PHANzgz/PHANAND_ONE/Demo/IMG-20191007-WA0003.jpeg

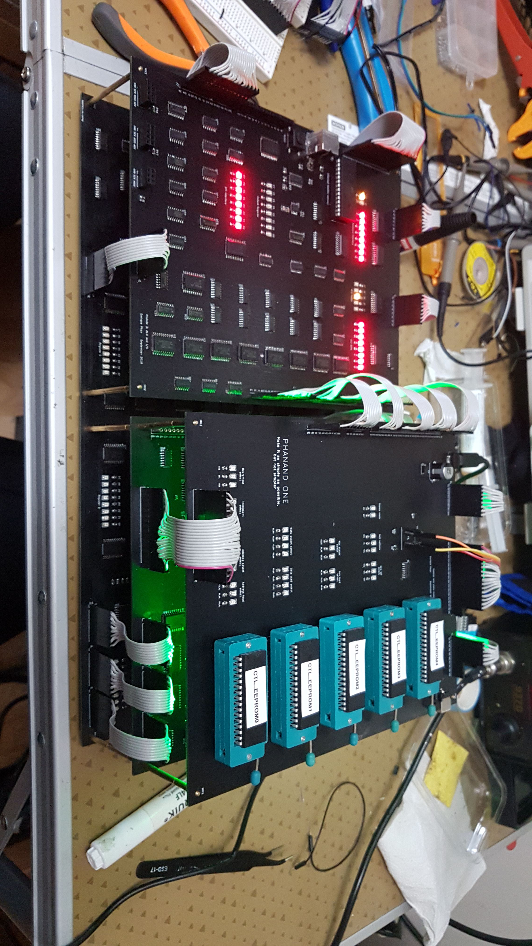
Demo/IMG-20191007-WA0003.jpeg
