PHANzgz/PHANAND_ONE/Demo/IMG-20190930-WA0027.jpeg

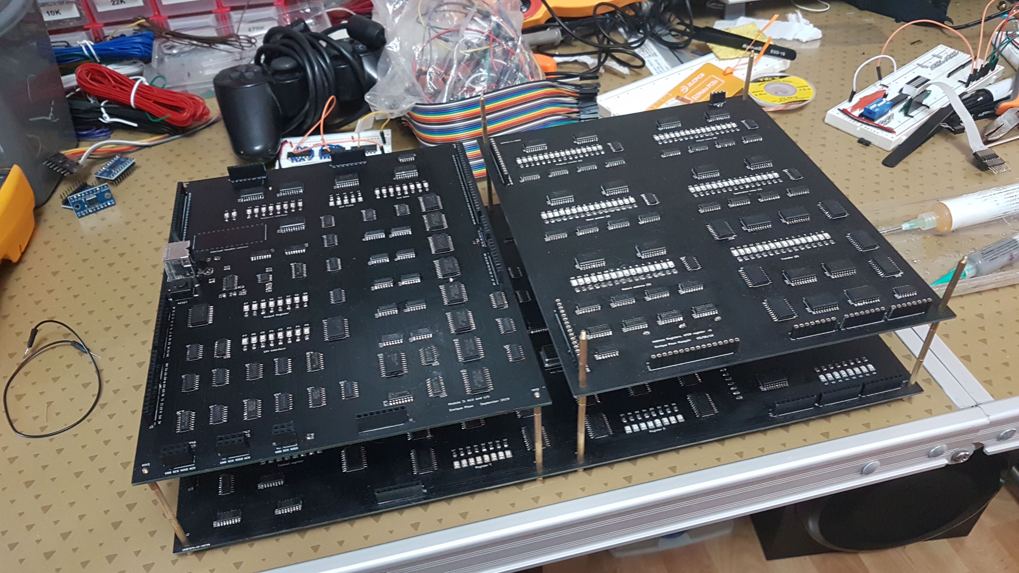
Demo/IMG-20190930-WA0027.jpeg
