PHANzgz/PHANAND_ONE/Documentation/Standalone_VGAcontroller.pdf

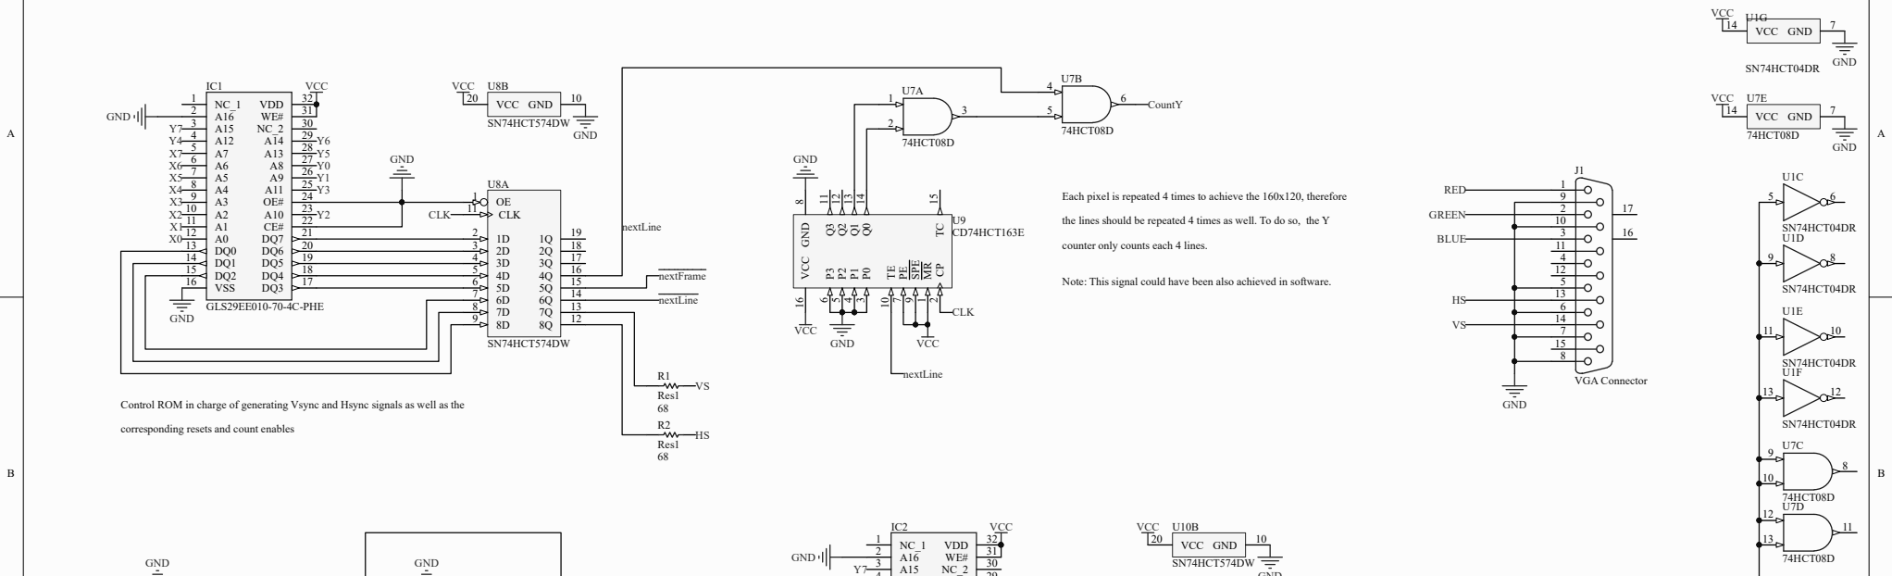
[picture p5: figure]
VCC 14; GND; SN74HCT04DR GND; VCC; NC_1 1 A16 2 A15 3 A12 4 A7 5 A6 6 A5 7 A4 8 A3 9 A2 10 A1 11 A0 12 DQ0 13 DQ1 14 DQ2 15 VSS 16; VDD; GLS29EE010-70-4C-PHE; OE 1 CLK 11; SN74HCT574DW; 10 VCC 20; CLK MR 1 CP 2 P0; 7 GND; 8 SPE; U9 CD74HCT163E; 74HCT08D; Res1; VGA Connector; nextLine; nextFrame; CountY; RED; BLUE; GREEN; corresponding resets and count enables; counter only counts each 4 lines.; SN74HCT04DR; CLK
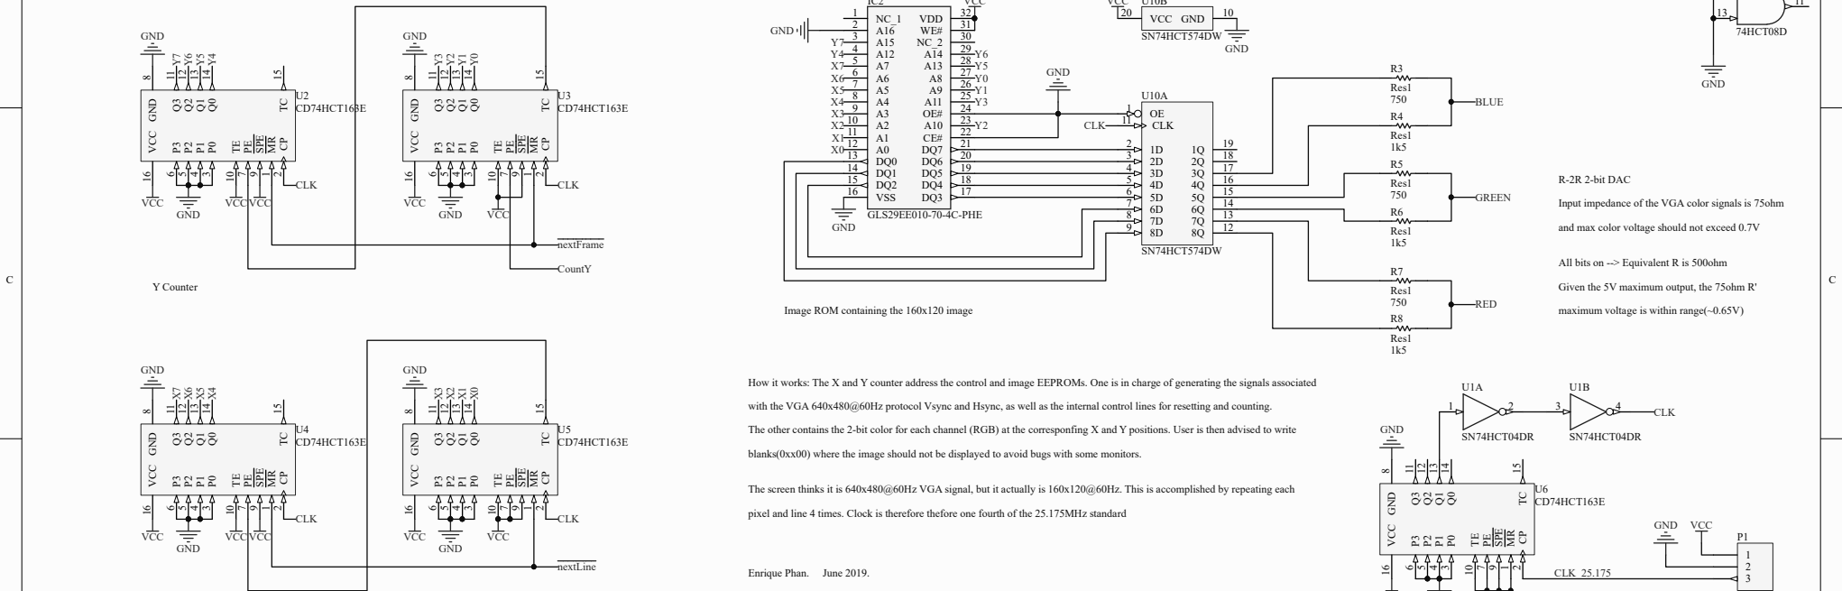
[picture p6: figure]
7 GND; 8 SPE; CD74HCT163E; CD74HCT163E MR 1 CP 2 P0; U3 CD74HCT163E; GND; VCC; CLK_25.175; GND VCC MR; U6 CD74HCT163E; SN74HCT04DR; CLK; VCCVCC; nextLine; CountY; nextFrame; A15 3 A12 4 A7 5 A6 6 A5 7 A4 8 A3 9 A2 10 A1 11 A0 12 DQ0 13 DQ1 14 DQ2 15 VSS 16; GLS29EE010-70-4C-PHE; OE 1 CLK 11; SN74HCT574DW; Res1; RED; GREEN; BLUE; Y Counter; Image ROM containing the 160x120 image; R-2R 2-bit DAC; All bits on --> Equivalent R is 500ohm; maximum voltage is within range(~0.65V); Enrique Phan. June 2019.
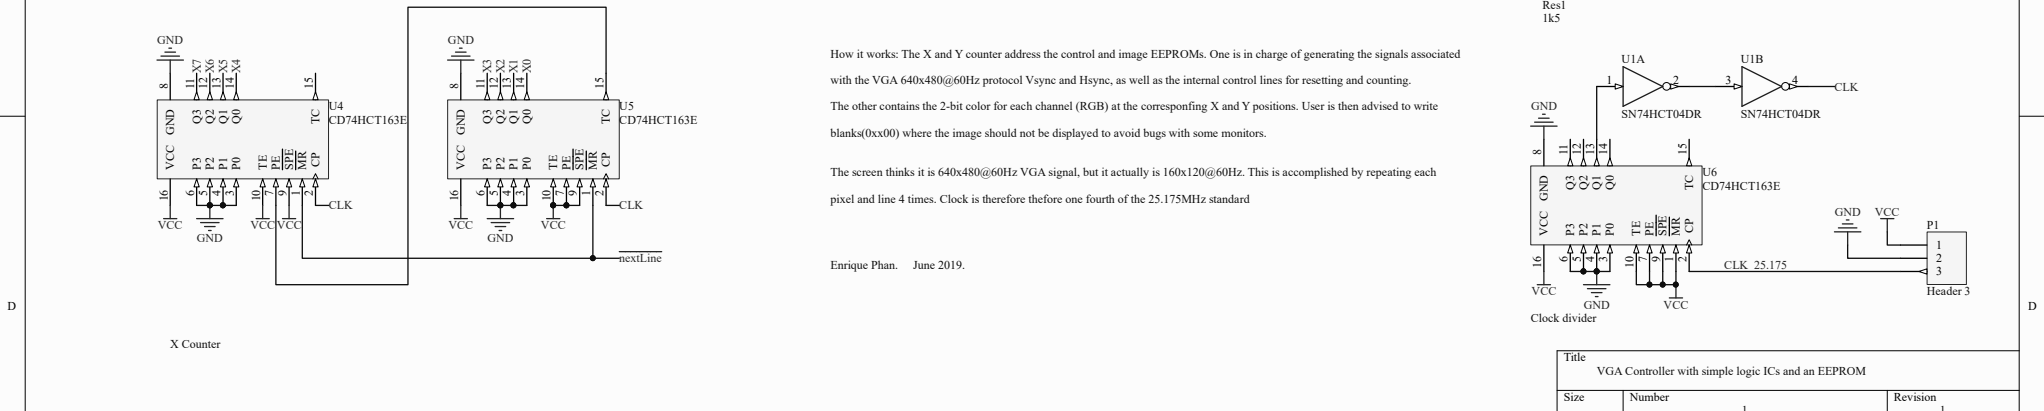
[picture p7: figure]
Title; Size; Number; Revision; Header 3; VCC; X Counter; Clock divider; GND

1

1

2

2

3

3

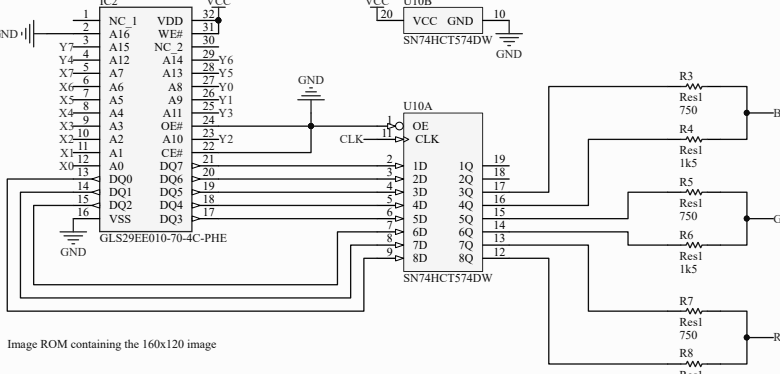
[picture p8: figure]

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
Date: | 07/07/2019 | Sheet | of
File: | C:\Users\..\VGAcrt.SchDoc | Drawn By:

VGA Controller with simple logic ICs and an EEPROM MR

### 9 TE 10 Q3 11 Q2 12 Q1 13 Q0 14 TC 15 VCC 16

### 9 TE 10 Q3 11 Q2 12 Q1 13 Q0 14 TC 15 VCC 16

### 9 TE 10 Q3 11 Q2 12 Q1 13 Q0 14 TC 15 VCC 16

### 9 TE 10 Q3 11 Q2 12 Q1 13 Q0 14 TC 15 VCC 16

### 9 TE 10 Q3 11 Q2 12 Q1 13 Q0 14 TC 15 VCC 16

CLK | CLK X⁷ X⁶ X⁵ X⁴ | X³ X² X¹ X⁰ Y⁷ Y⁶ Y⁵ Y⁴ | Y³ Y² Y¹ Y⁰

### 9 TE 10 Q3 11 Q2 12 Q1 13 Q0 14 TC 15 VCC 16

Enrique Phan

1 1

1 1

Control ROM in charge of generating Vsync and Hsync signals as well as the

Each pixel is repeated 4 times to achieve the 160x120, therefore

the lines should be repeated 4 times as well. To do so, the Y

Note: This signal could have been also achieved in software.

Input impedance of the VGA color signals is 75ohm

and max color voltage should not exceed 0.7V

Given the 5V maximum output, the 75ohm R'

How it works: The X and Y counter address the control and image EEPROMs. One is in charge of generating the signals associated

with the VGA 640x480@60Hz protocol Vsync and Hsync, as well as the internal control lines for resetting and counting.

The other contains the 2-bit color for each channel (RGB) at the corresponfing X and Y positions. User is then advised to write

blanks(0xx00) where the image should not be displayed to avoid bugs with some monitors.

The screen thinks it is 640x480@60Hz VGA signal, but it actually is 160x120@60Hz. This is accomplished by repeating each

pixel and line 4 times. Clock is therefore thefore one fourth of the 25.175MHz standard
