PHANzgz/PHANAND_ONE/Demo/20190929_234833.jpg

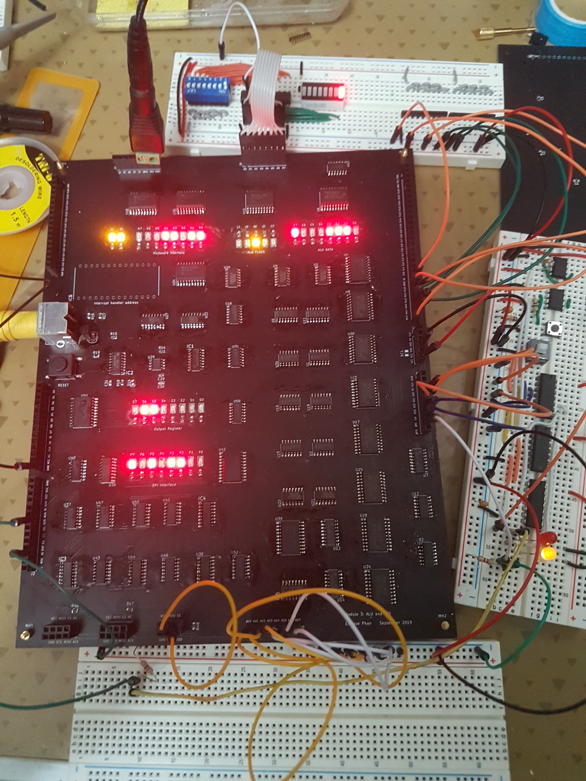
Demo/20190929_234833.jpg
