PHANzgz/PHANAND_ONE/Demo/AddressRegisters.jpeg

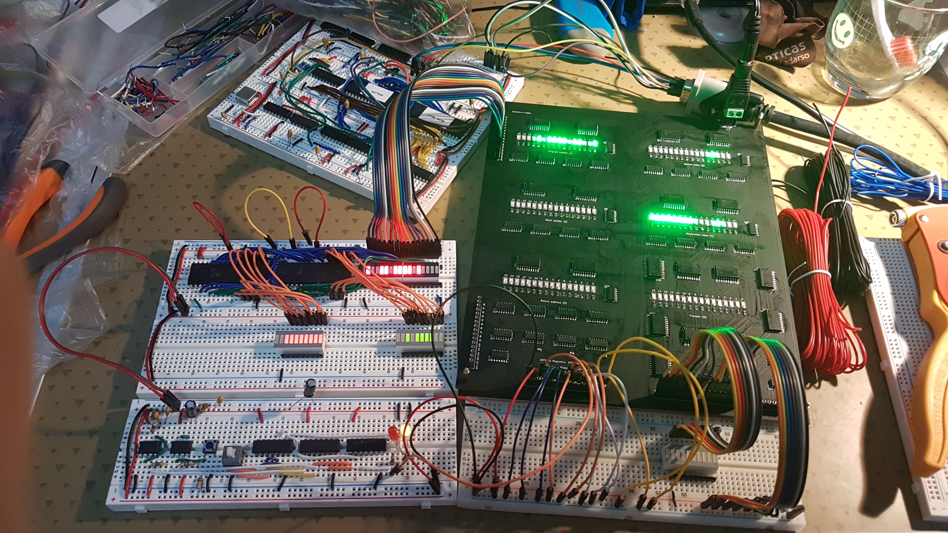
Demo/AddressRegisters.jpeg
