PHANzgz/PHANAND_ONE/Demo/DataModule.jpg

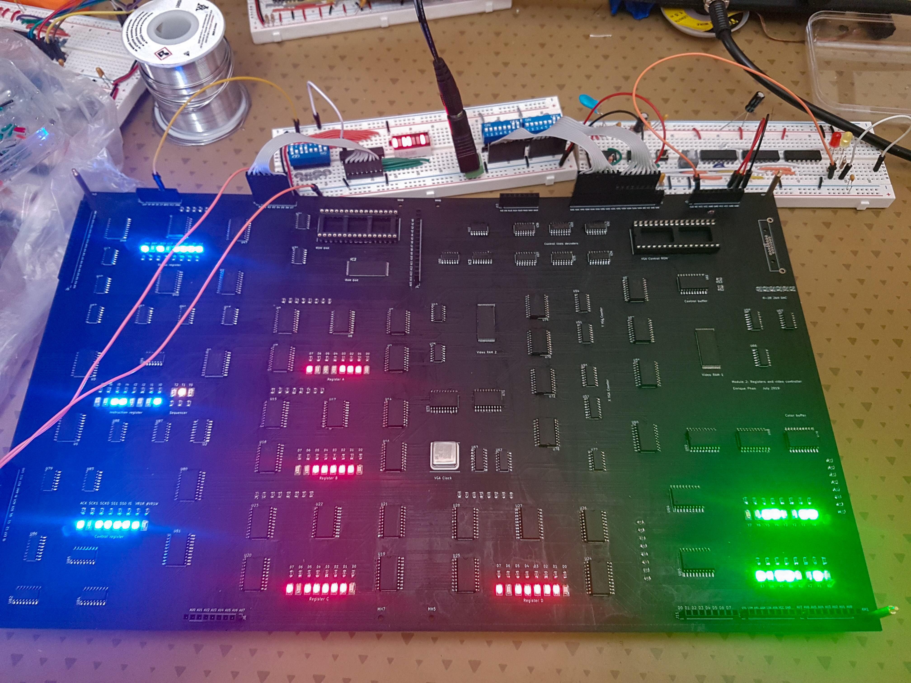
Demo/DataModule.jpg
