PHANzgz/PHANAND_ONE/Demo/VGA_Controller.jpg

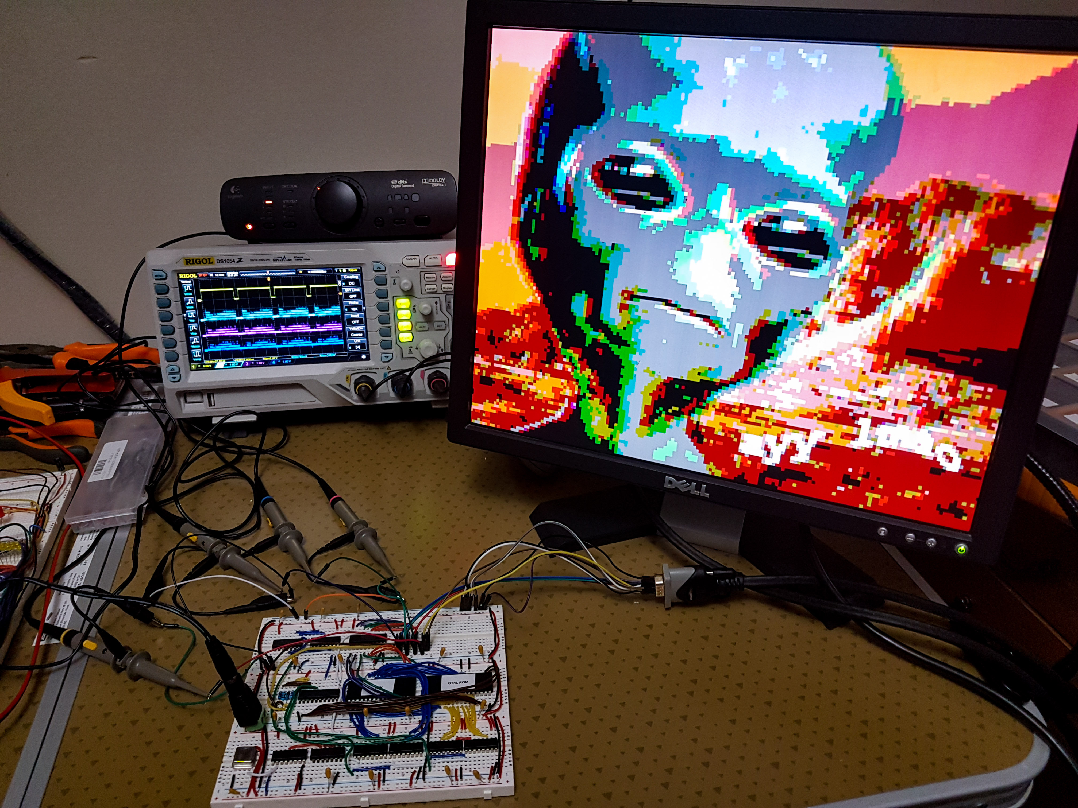
Demo/VGA_Controller.jpg
