PHANzgz/PHANAND_ONE/Schematics/addressRegisters.pdf

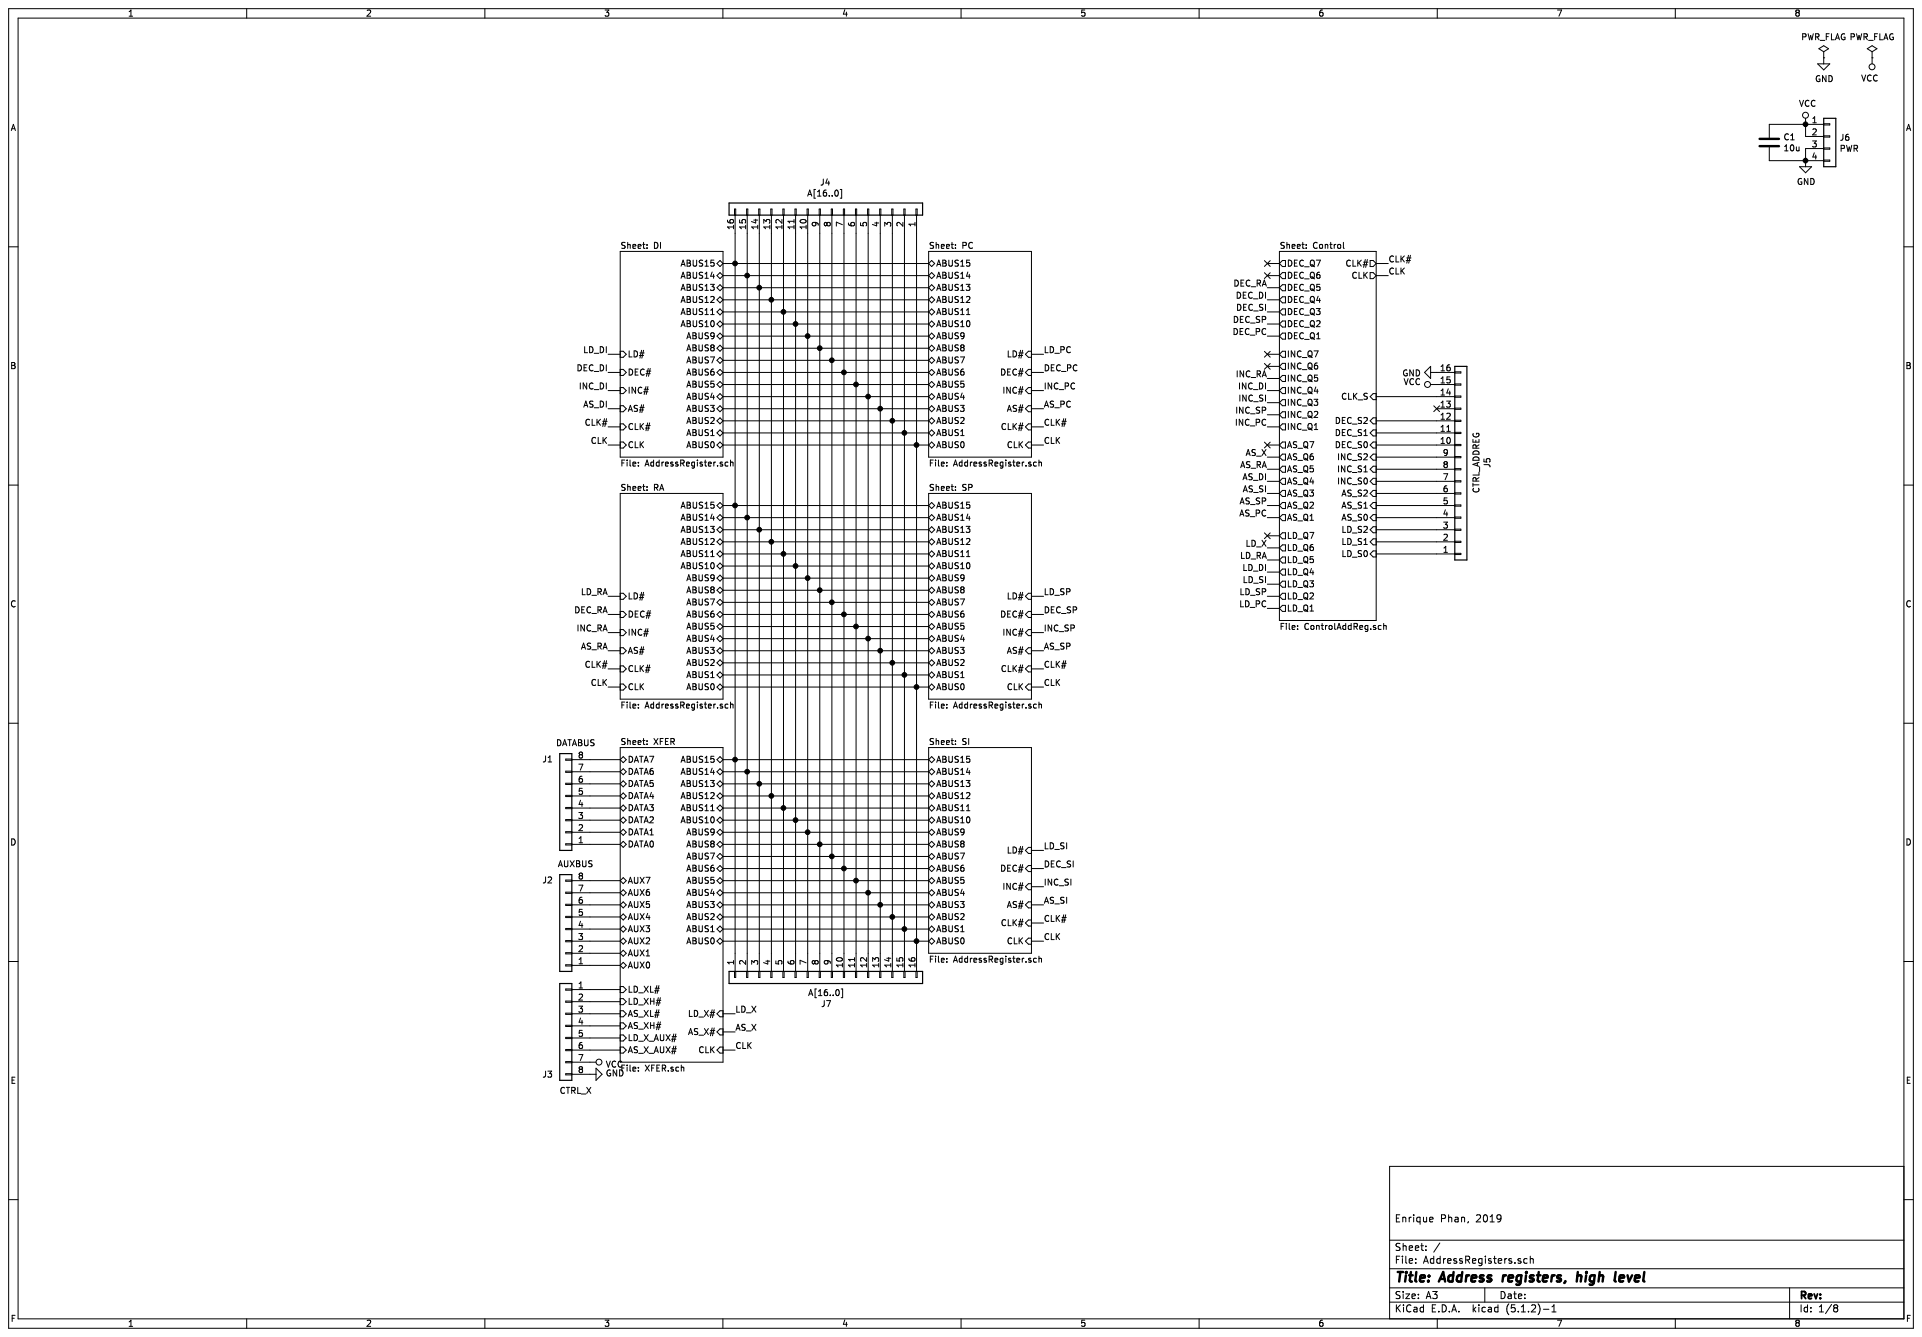
[picture p14: page 1]

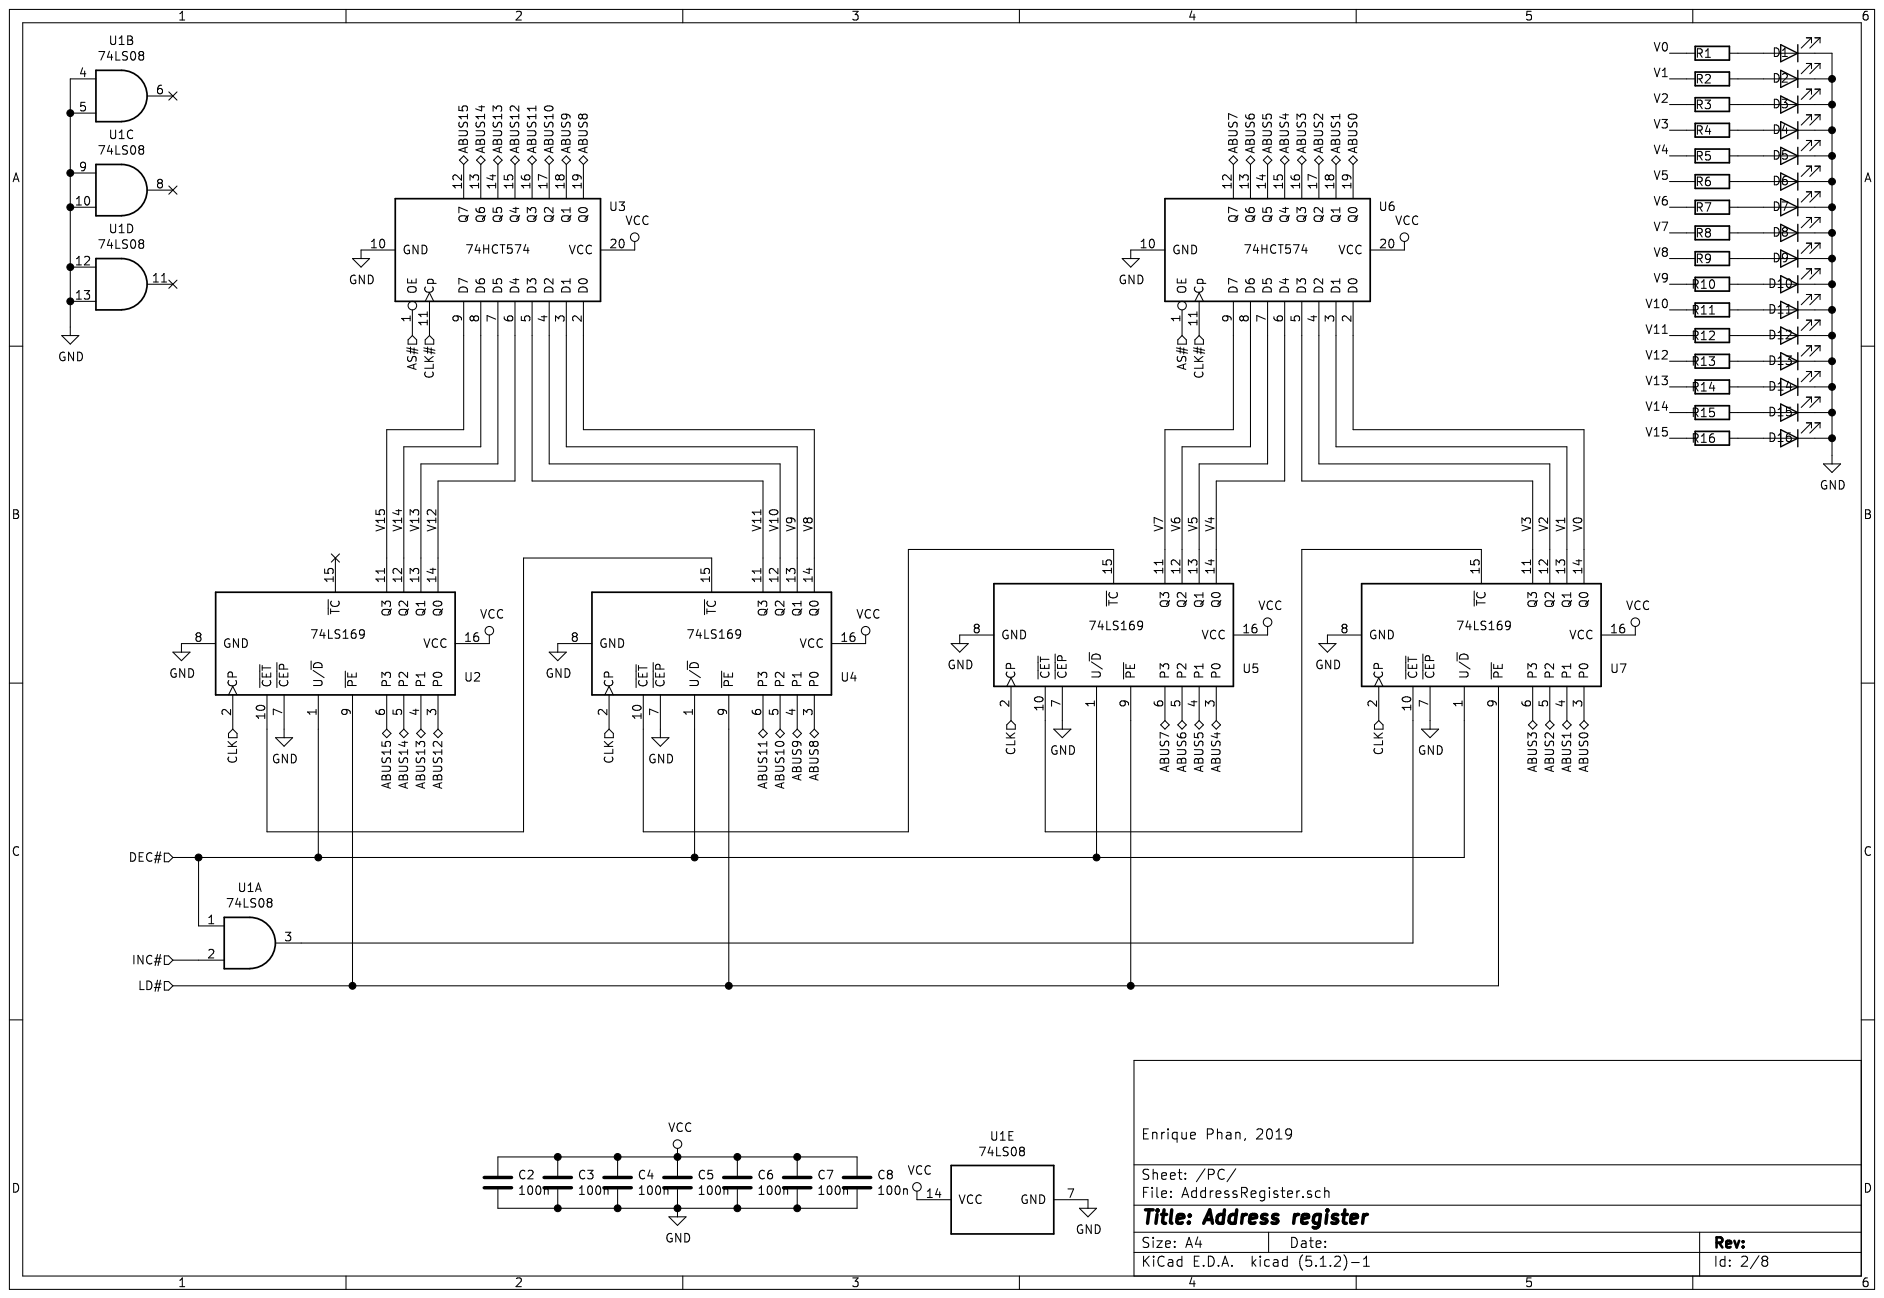
[picture p15: page 2]

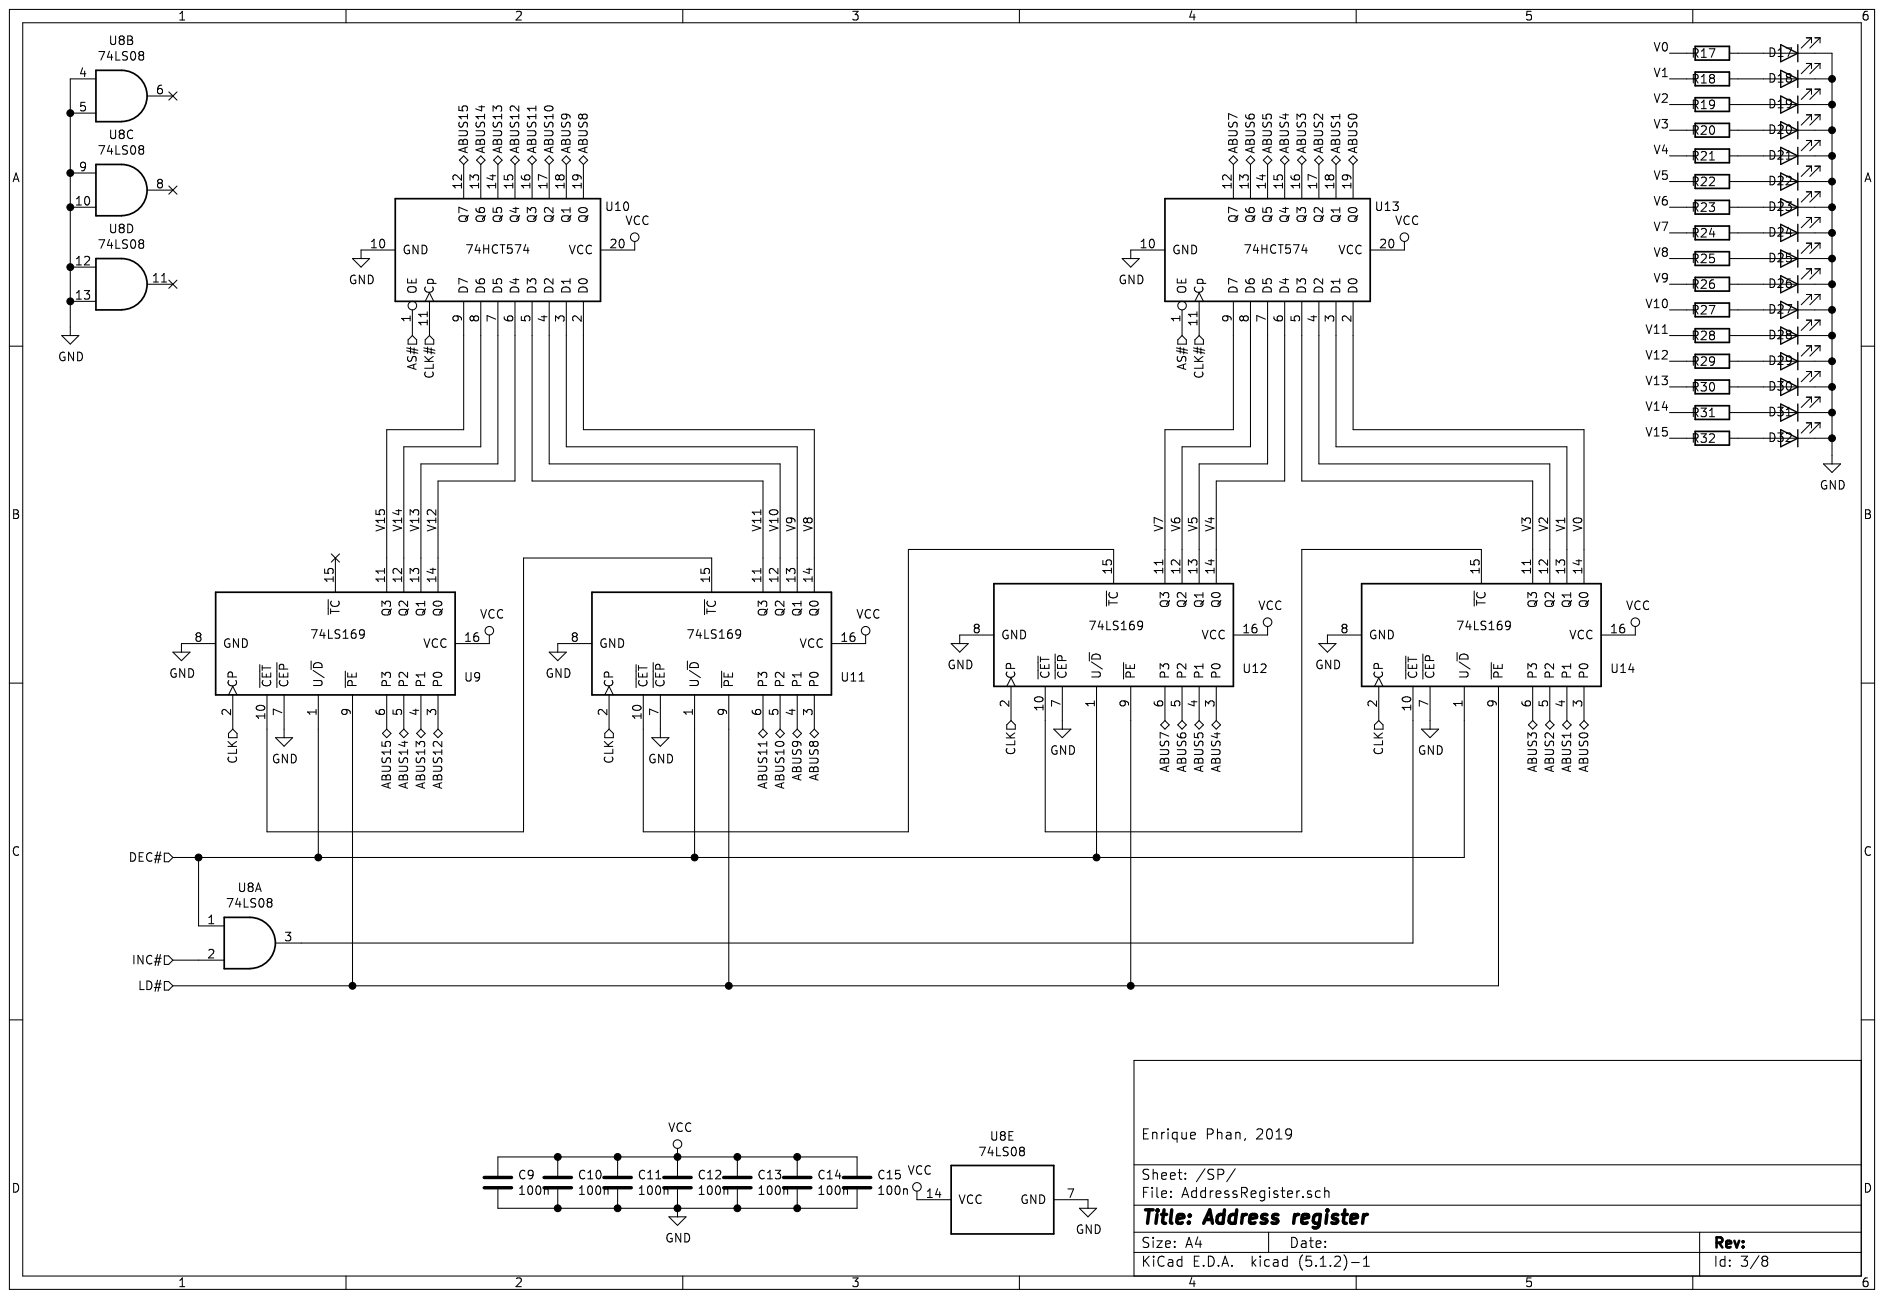
[picture p16: page 3]

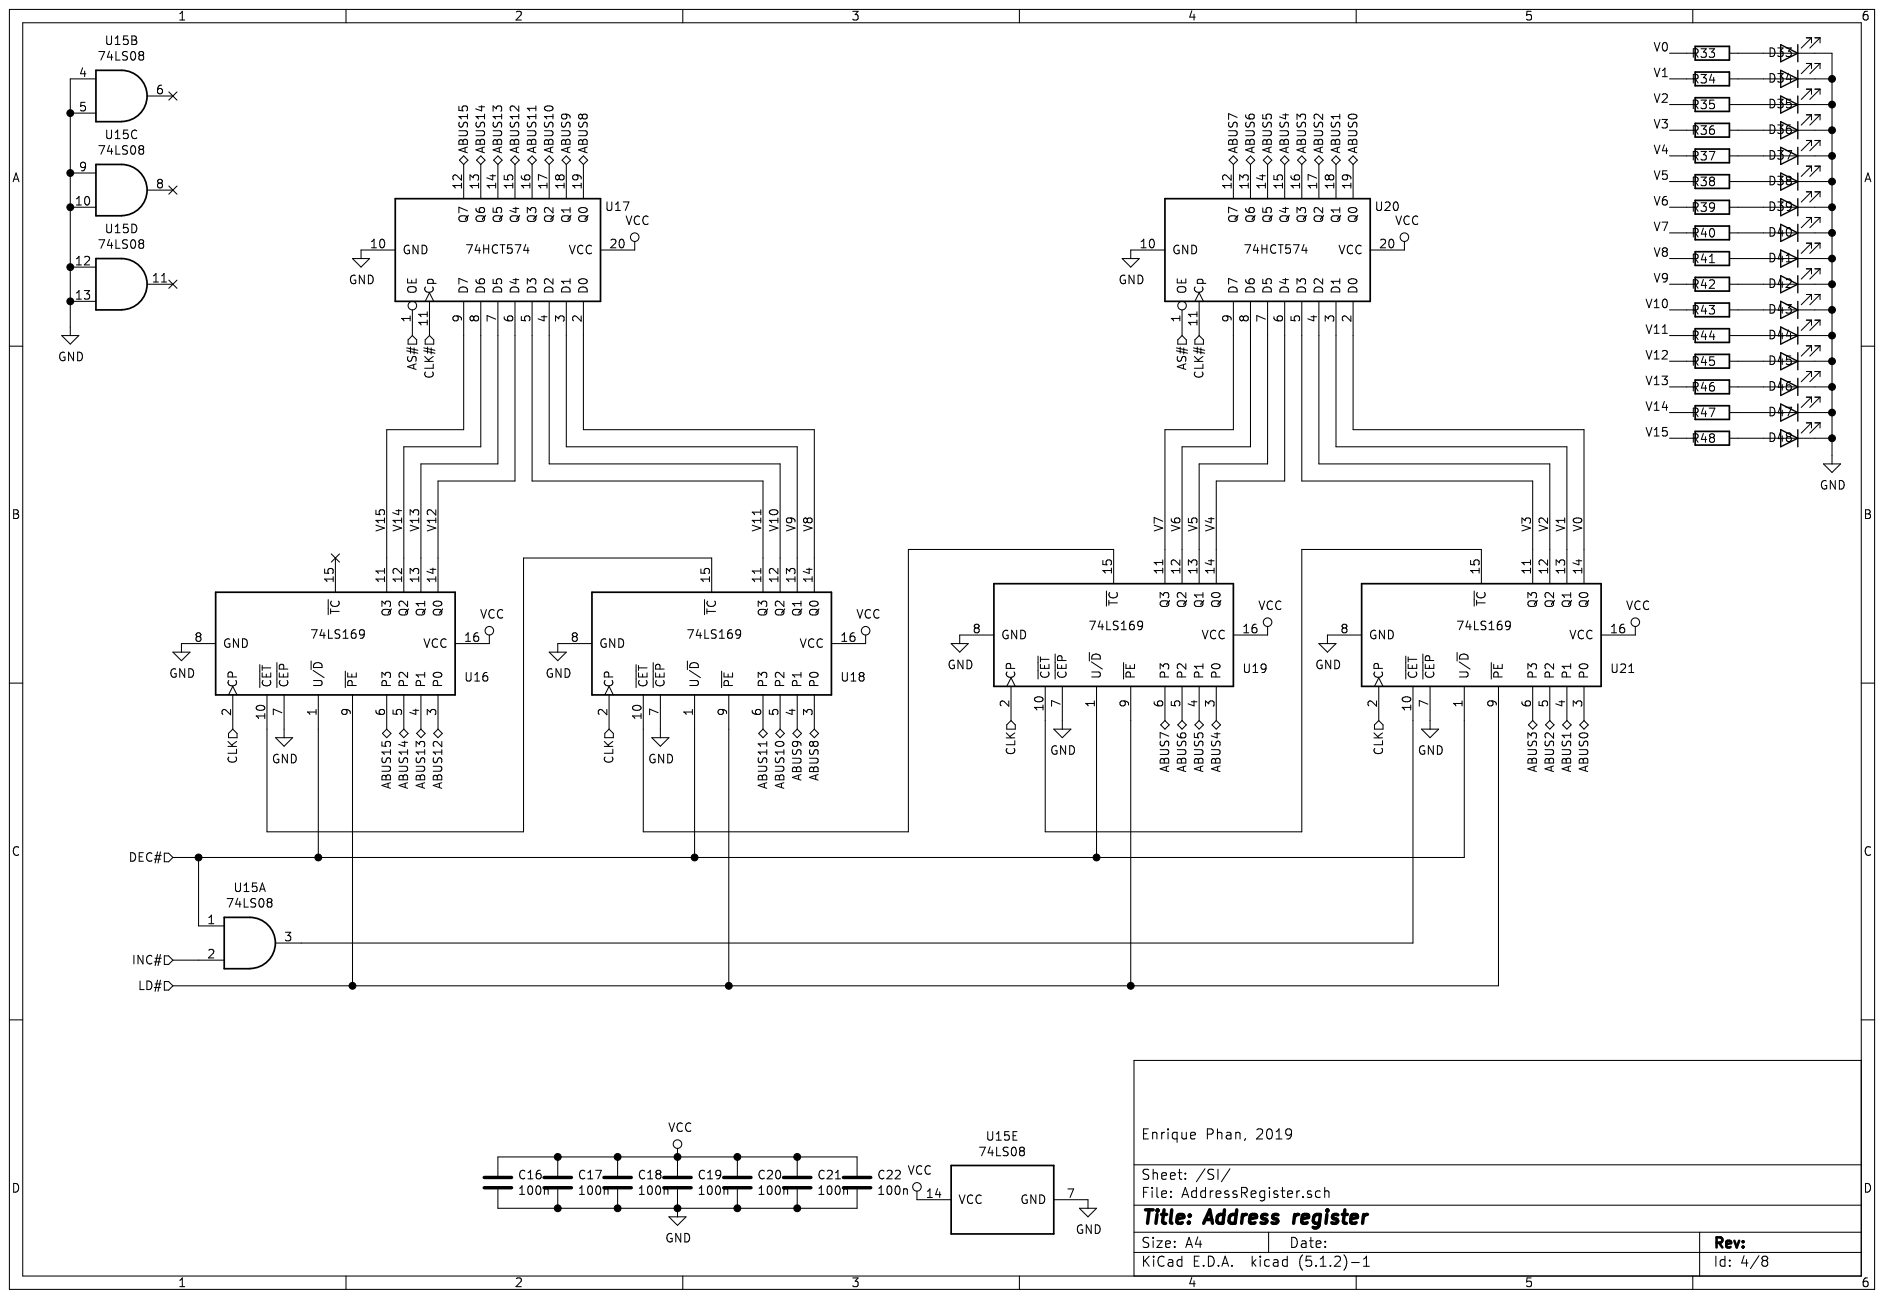
[picture p17: page 4]

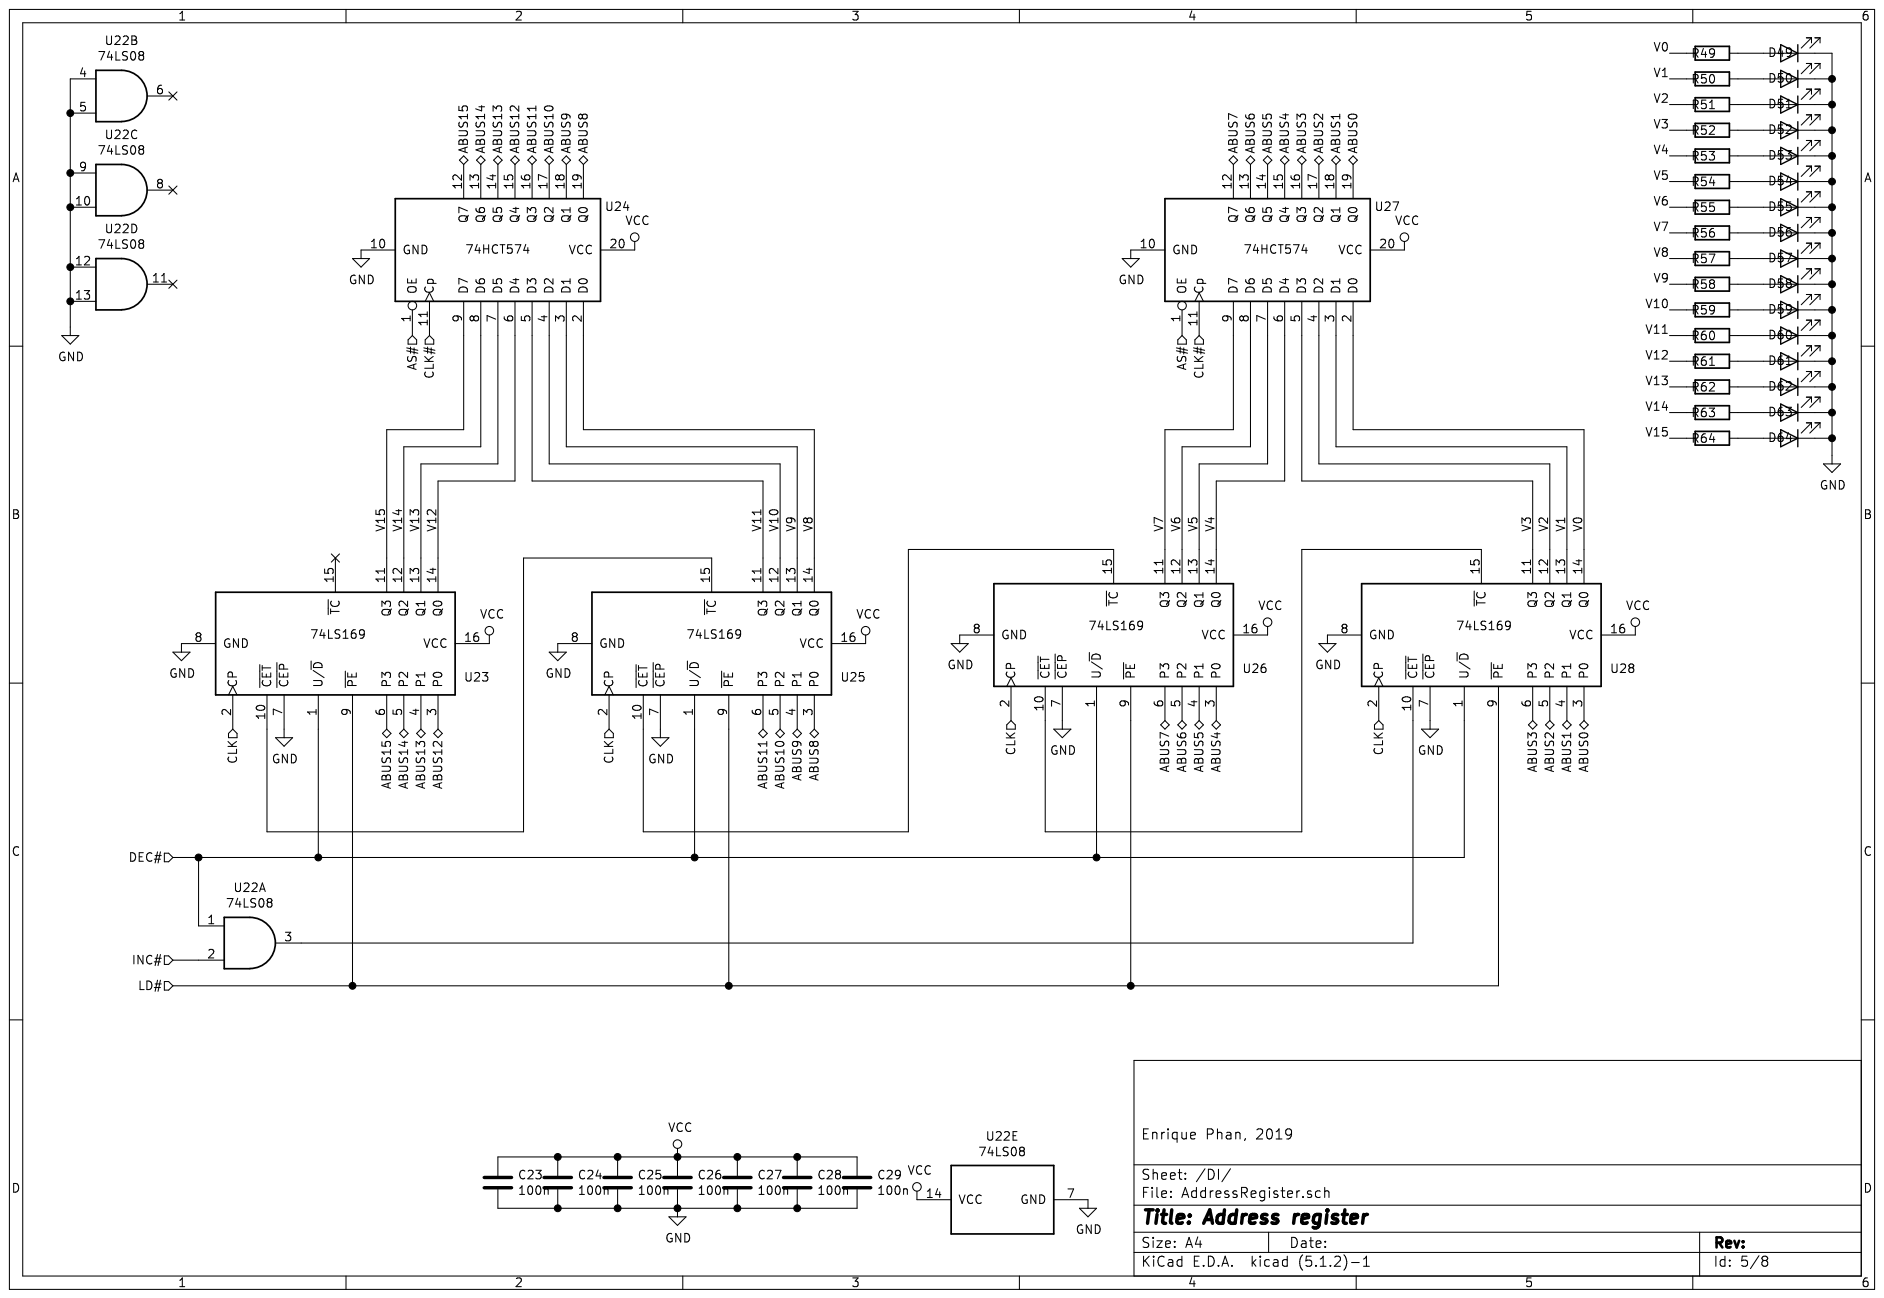
[picture p18: page 5]

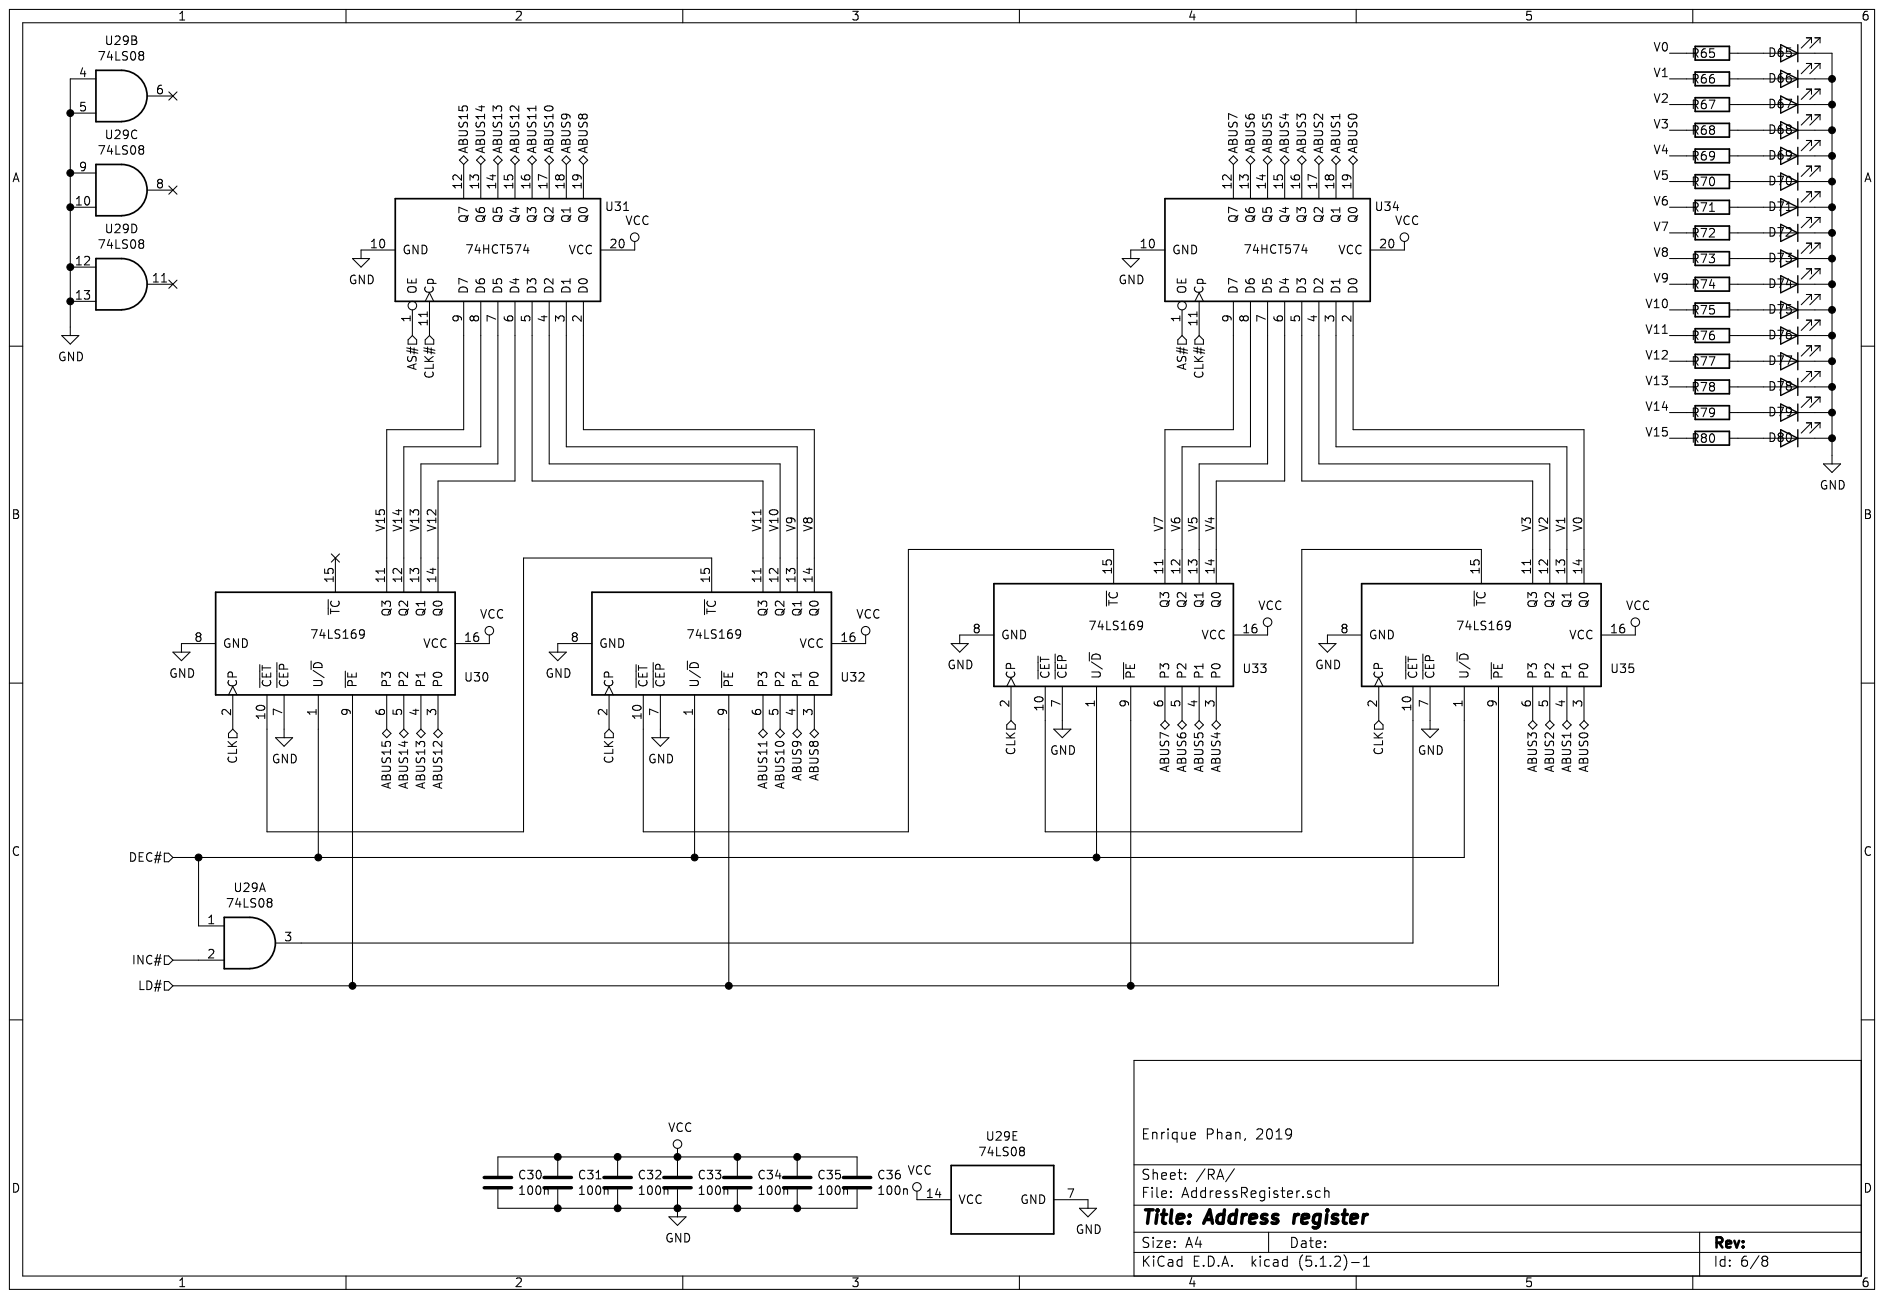
[picture p19: page 6]

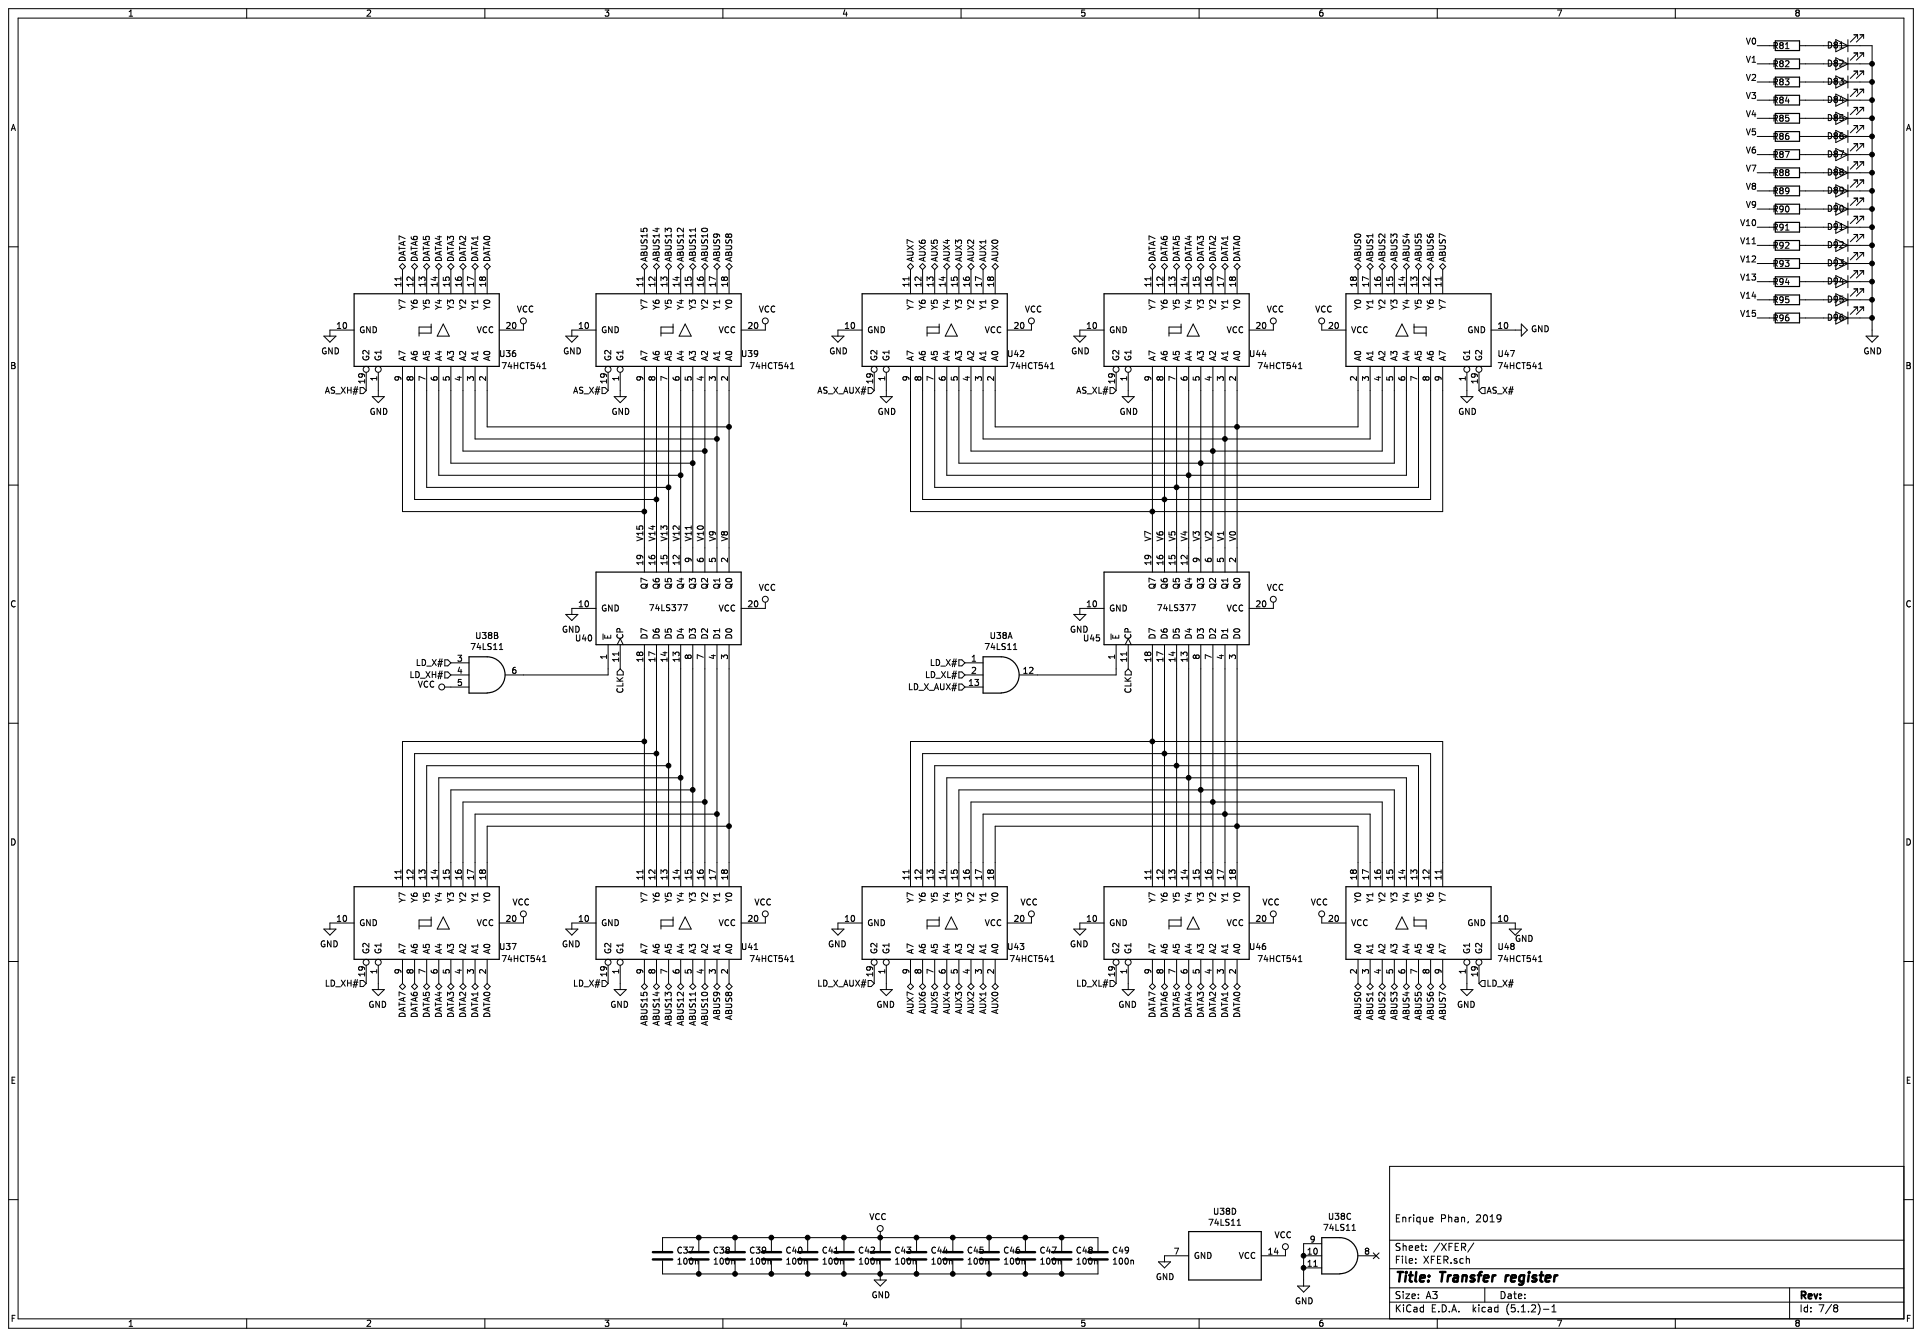
[picture p20: page 7]

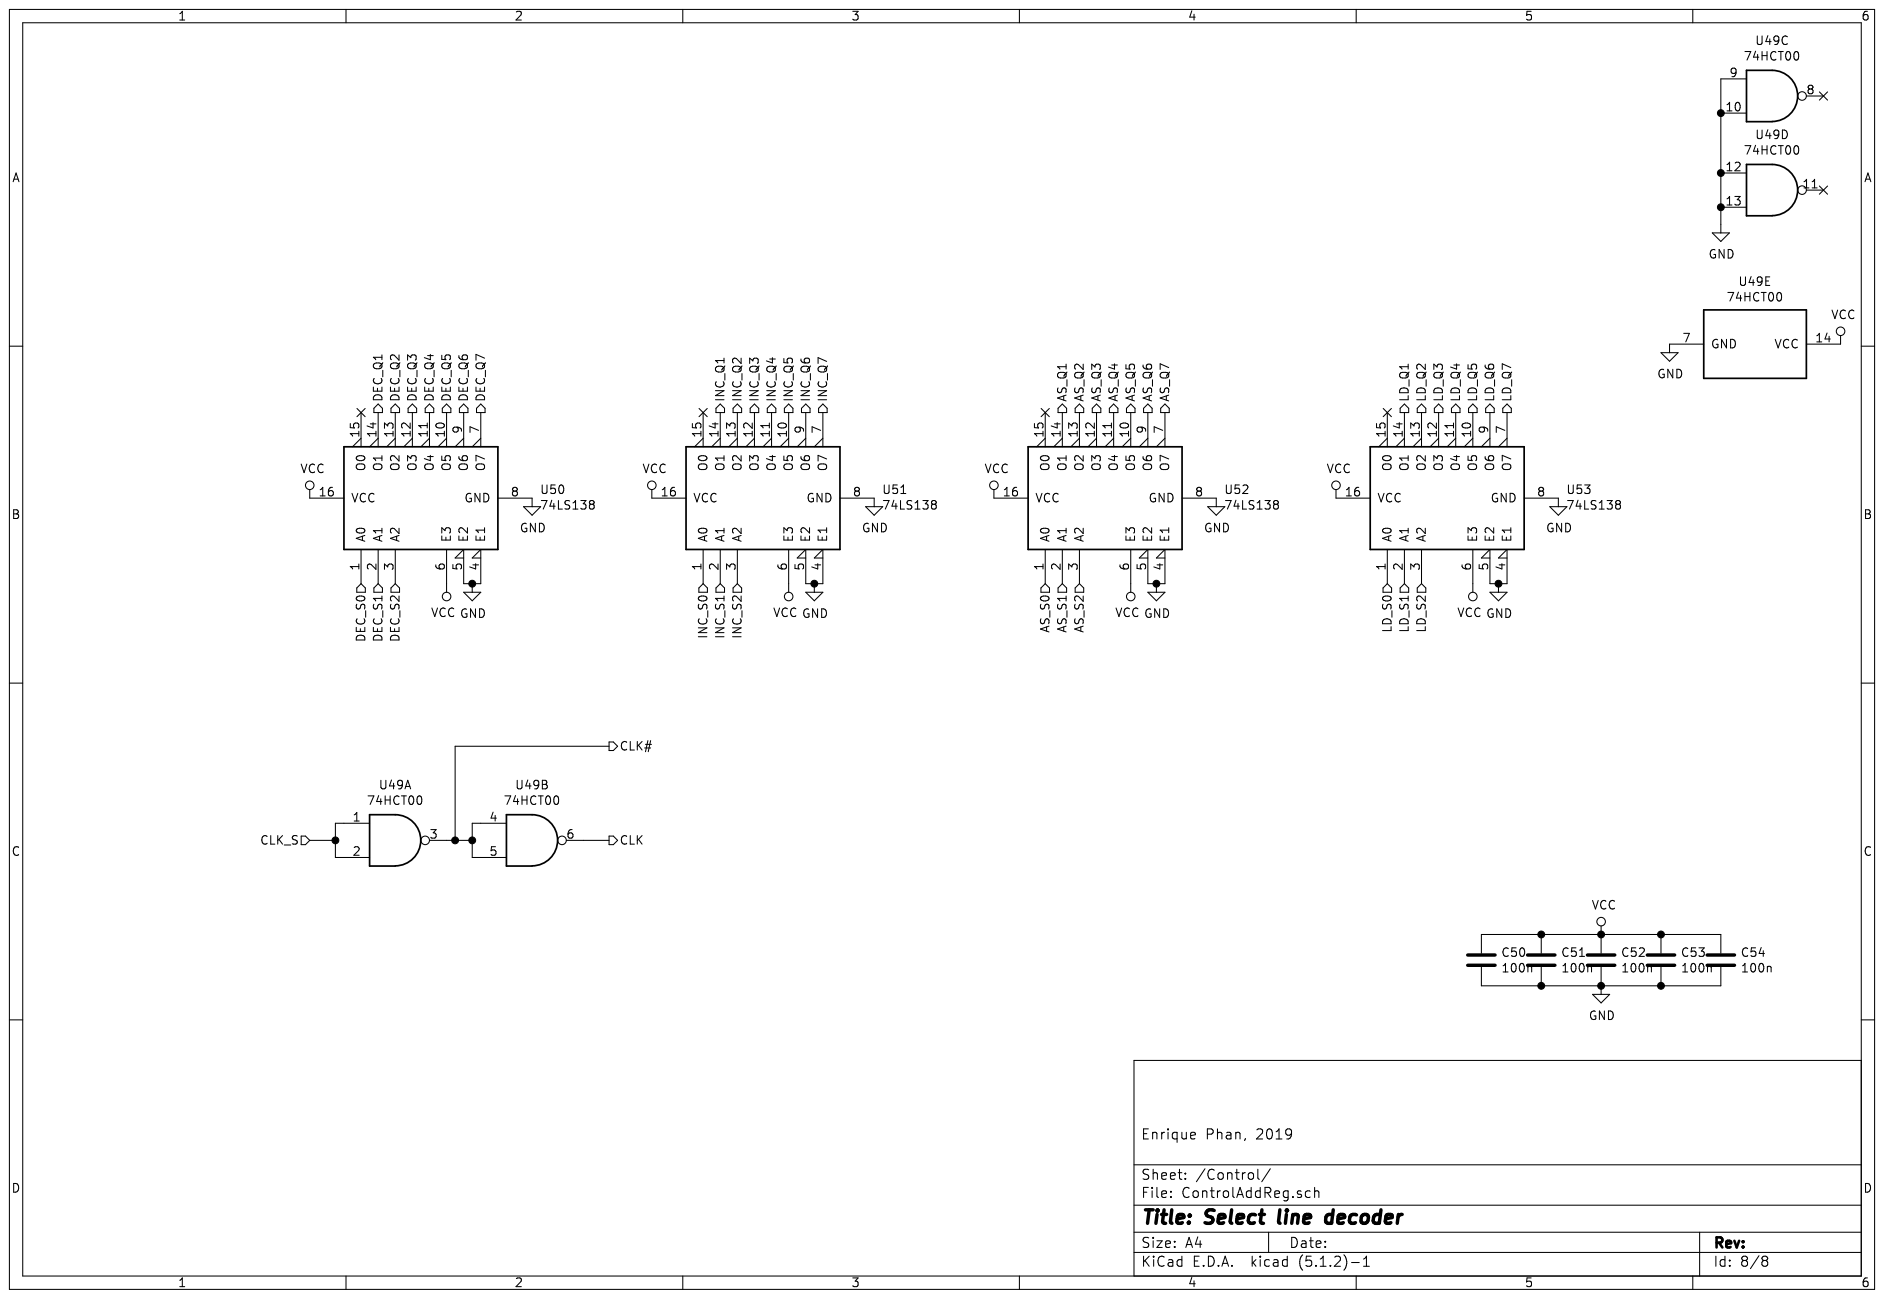
[picture p21: page 8]
