PHANzgz/PHANAND_ONE/Schematics/controlModule.pdf

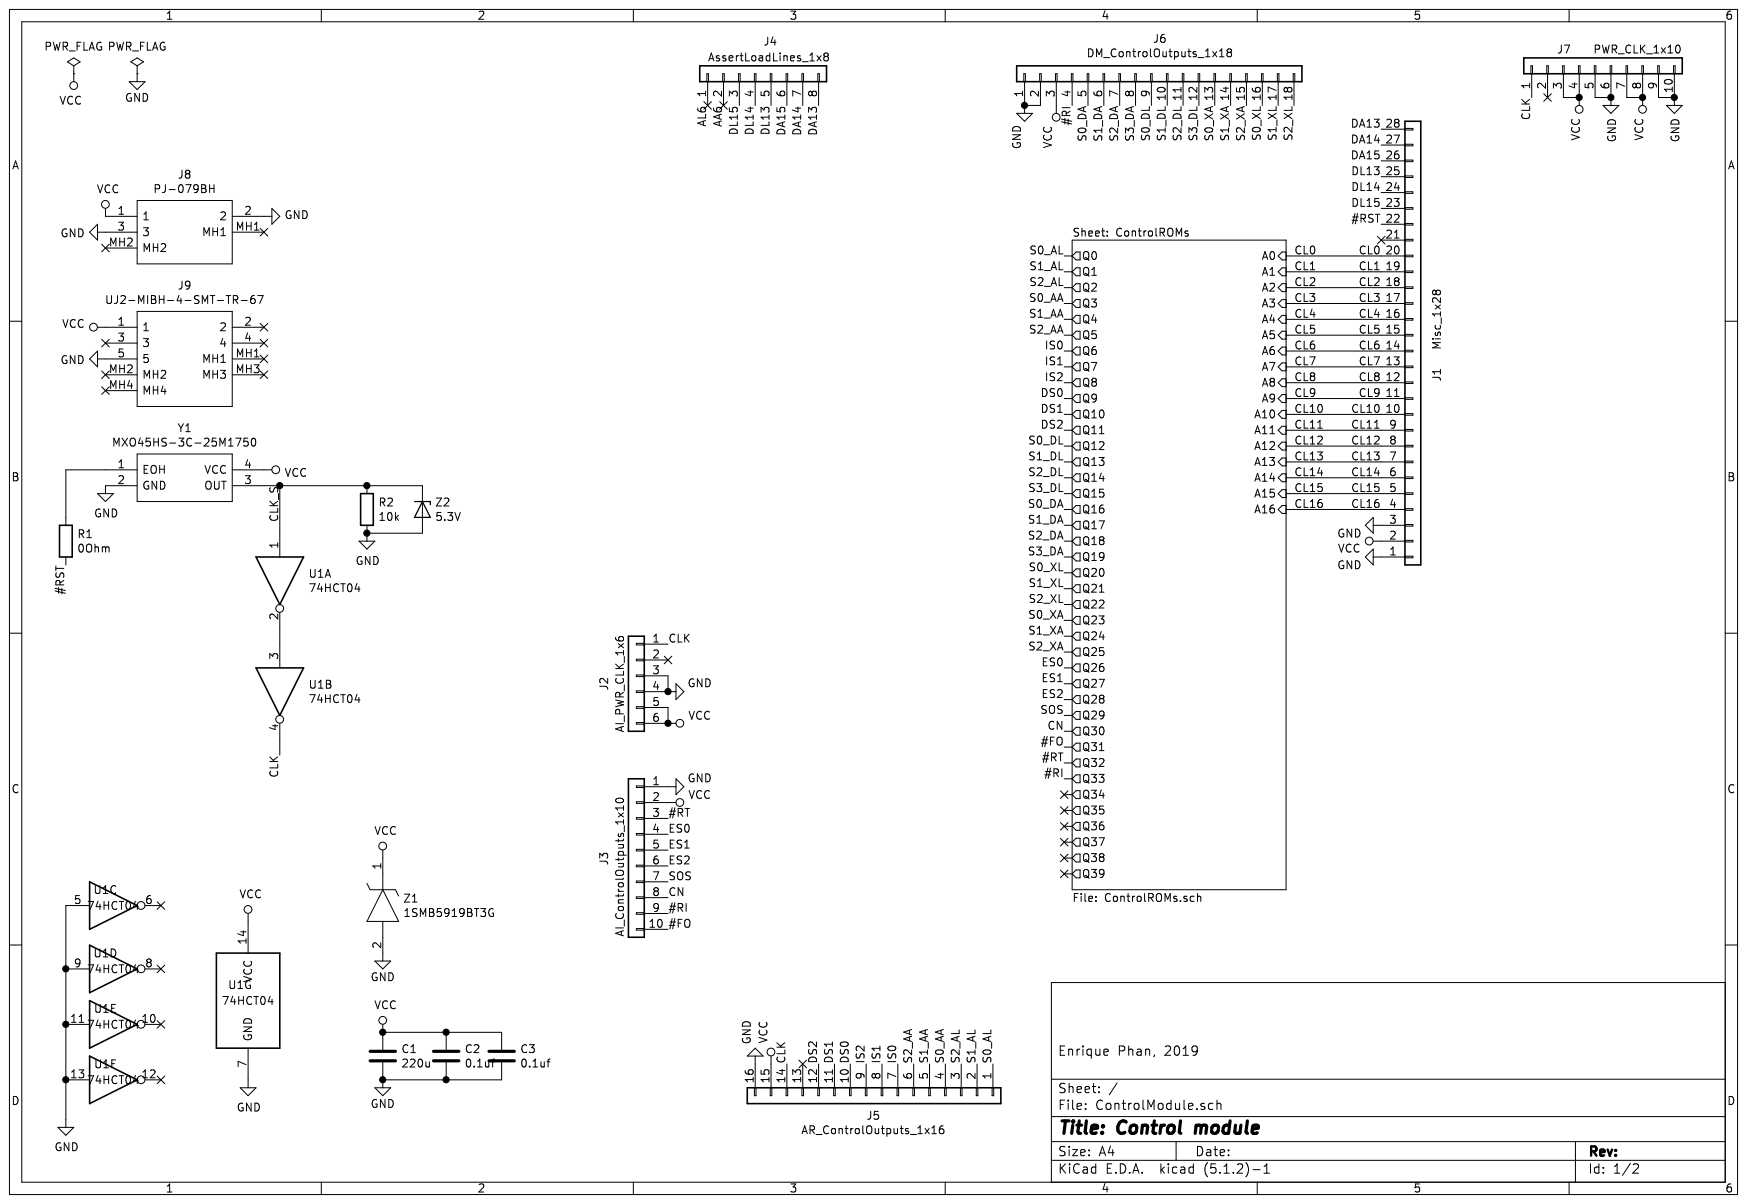
[picture p28: page 1]

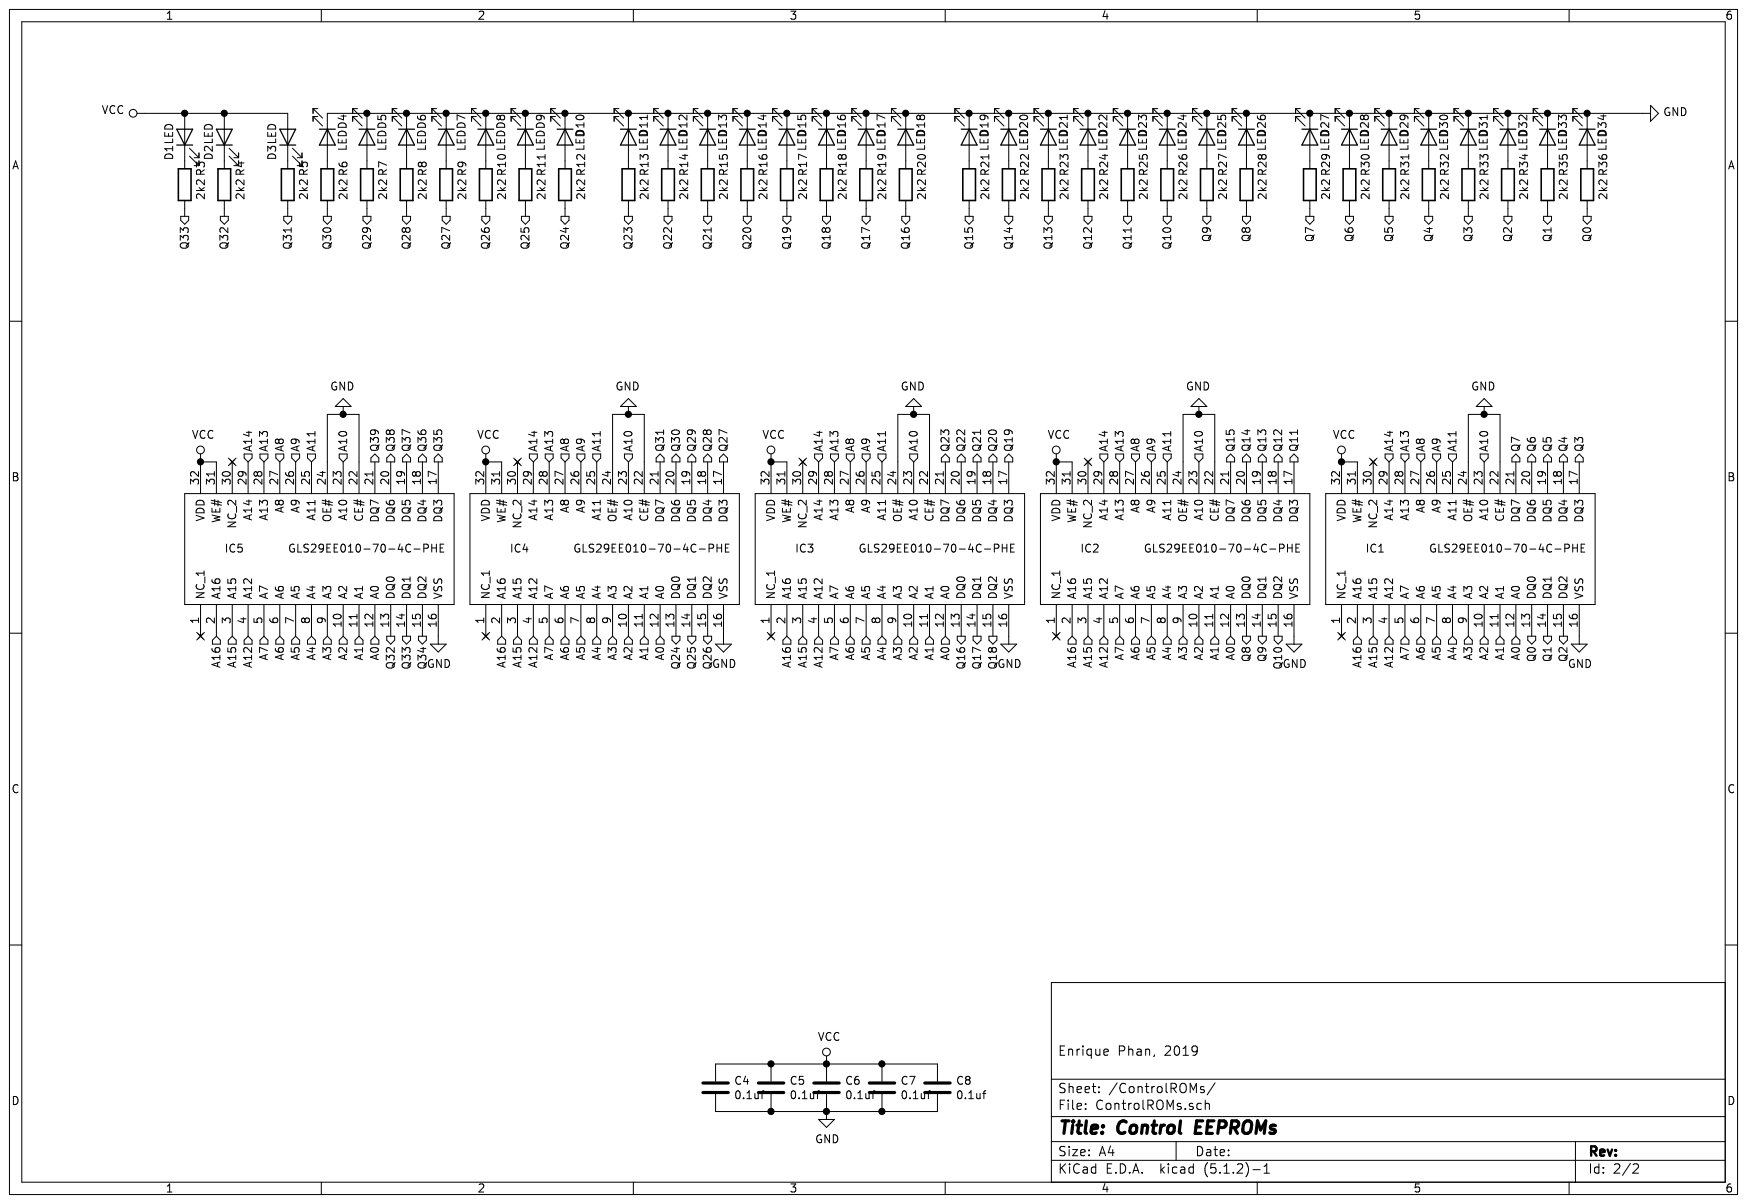
[picture p29: page 2]
