PHANzgz/PHANAND_ONE/Documentation/Architecture_PHANAND.pdf

## Architecture overview

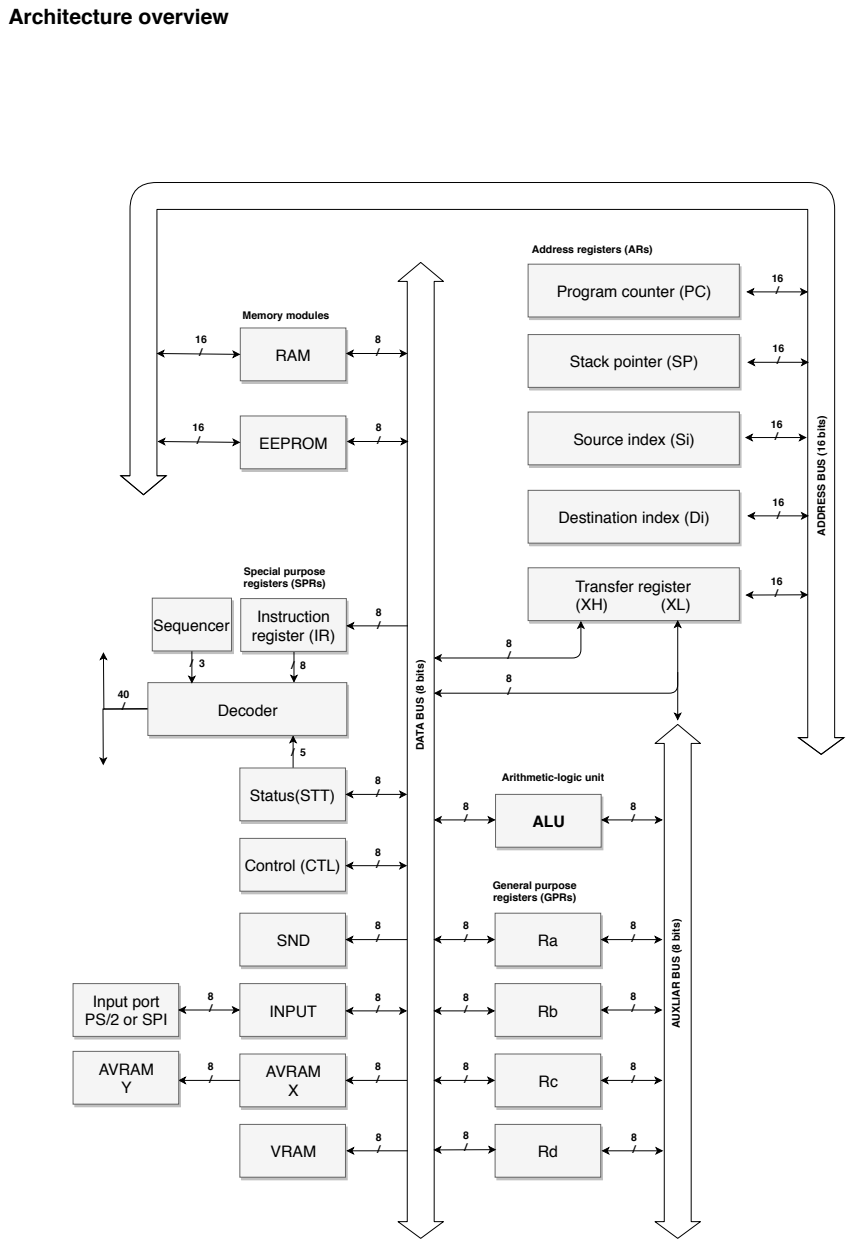
[picture p41: page 1]
RAM; EEPROM; ALU; Transfer register; General purpose registers (GPRs); Memory modules; SND; INPUT; AVRAM X; VRAM; AVRAM Y; Status(STT); Control (CTL); Instruction register (IR); Special purpose registers (SPRs); Decoder; Sequencer

Address registers (ARs)

Program counter (PC)

Stack pointer (SP)

ADDRESS BUS (16 bits)

Source index (Si)

Destination index (Di)

DATA BUS (8 bits)

Arithmetic-logic unit

AUXLIAR BUS (8 bits)

Input port
PS/2 or SPI
