PHANzgz/PHANAND_ONE/Demo/VGAcontrollerNotes0.jpg

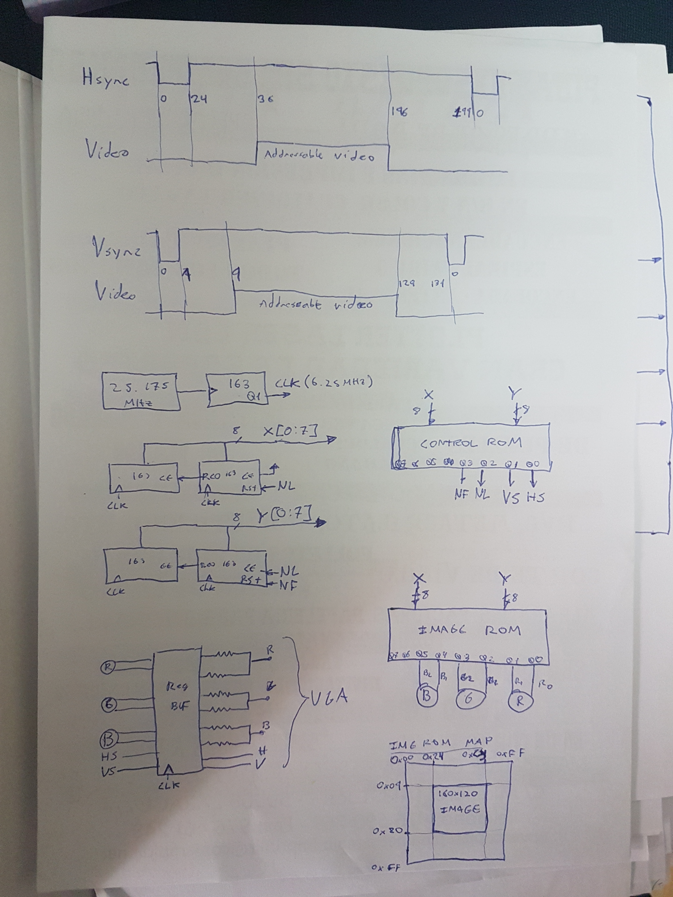
Demo/VGAcontrollerNotes0.jpg
